sai-ydev/ESP32C3-RF/README.md

# ESP32C3-RF
 
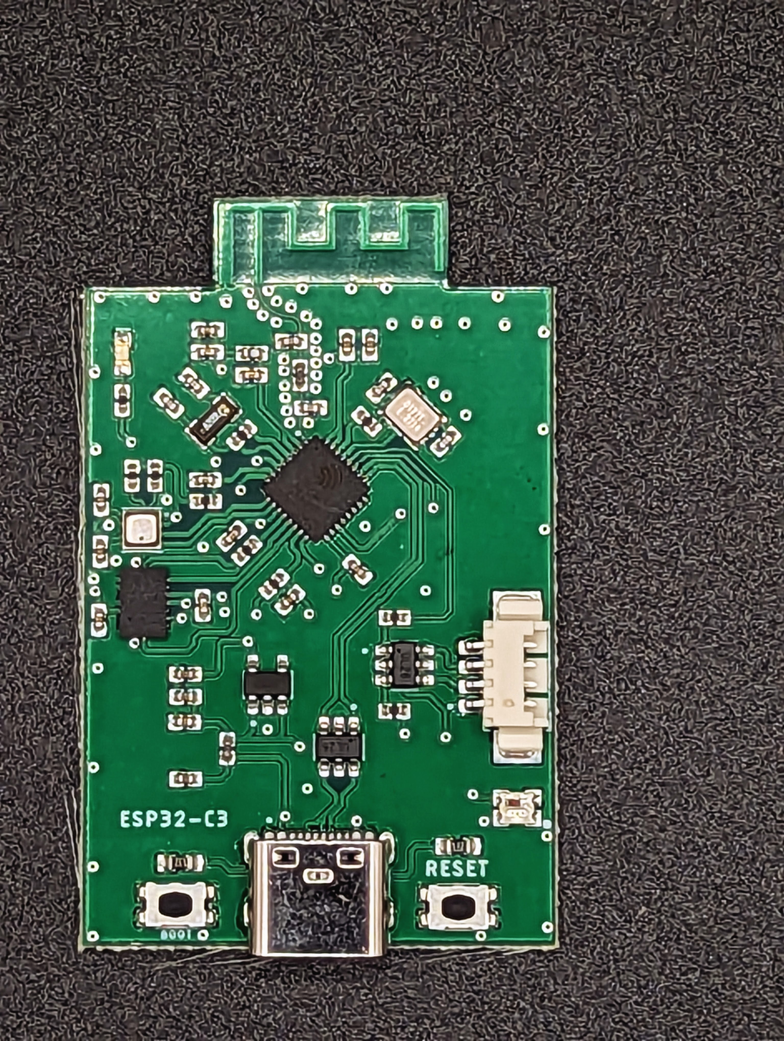
[picture p1: img/esp32_pcb_assembled.jpg]
PCB
