sai-ydev/ESP32C3-RF/hardware/gerbers/esp32_rf_top_bom.xlsx

Comment | Designator | Footprint | LCSC Part #
0.1uF | C5 C6 C8 C9 C10 C11 C12 C13 C16 C17 C18 C19 C20 C22 C23 | 402 | CL05B104KO5NNNC
1.0uF | C3 C4 | 402 | 0402X105K250NT
2.2NH | L4 L2 | 402 | HFM1005-2N2S
2nH | L1 | 402 | BSCH001005052N0SCS
3.3pF | C21 C24 | 402 | AC0402BRNPO9BN3R3
4.7K | R11 R12 | 402 | SCR0402J4K7
5.1k | R1 R2 | 603 | RMC06035.1K1%N
8pF | C1 C2 C14 C15 | 402 | C0402C0G8R0C500NTB
10K | R4 R6 | 402 | SCR0402J0103
10M | R5 | 402 | SCR0402F10M
22 | R3 R7 | 402 | CR0402J22R0Q10Z
330 | R10 | 402 | SCR0603F330R
470 | R8 R9 | 402 | SCR0402F470R
53261-0471 | J2 | MOLEX_53261-0471 | 532610471
AP2112K-3.3TRG1 | U2 | SOT95P285X140-5N | AP2112K-3.3TRG1
BME280 | U5 | PSON65P250X250X100-8N | BME280
BMI055 | IC1 | QFN50P300X450X100-16N | BMI055
ESP32-C3FH4 | U1 | QFN50P500X500X90-33N | ESP32-C3FH4
FC-135_32.7680KA-A0 | Y2 | XTAL_FC-135_32.7680KA-A0 | FC-135 32.7680KA-AC
MOMENTARY-SWITCH-SPST-SMD-4.6X2.8MM | BOOT RESET | TACTILE_SWITCH_SMD_4.6X2.8MM | KMR231GLFS
RED | D1 | LED-0603 | NCD0603R1
TYPE-C-31-M-12 | J1 | HRO_TYPE-C-31-M-12 | TYPE-C-31-M-12
USBLC6-2SC6 | U4 U6 | SOT95P280X145-6N | USBLC6-2SC6
WS2812B-2020 | L3 | WS2812B-2020 | WS2812B-2020
X1E000021017700 | Y1 | CRYSTAL-SMD-3.2X2.5MM | X1E000021017700
