sai-ydev/ESP32C3-RF/hardware/esp32_rf.brd

## EAGLE design hardware/esp32_rf.brd (2023-02-13)

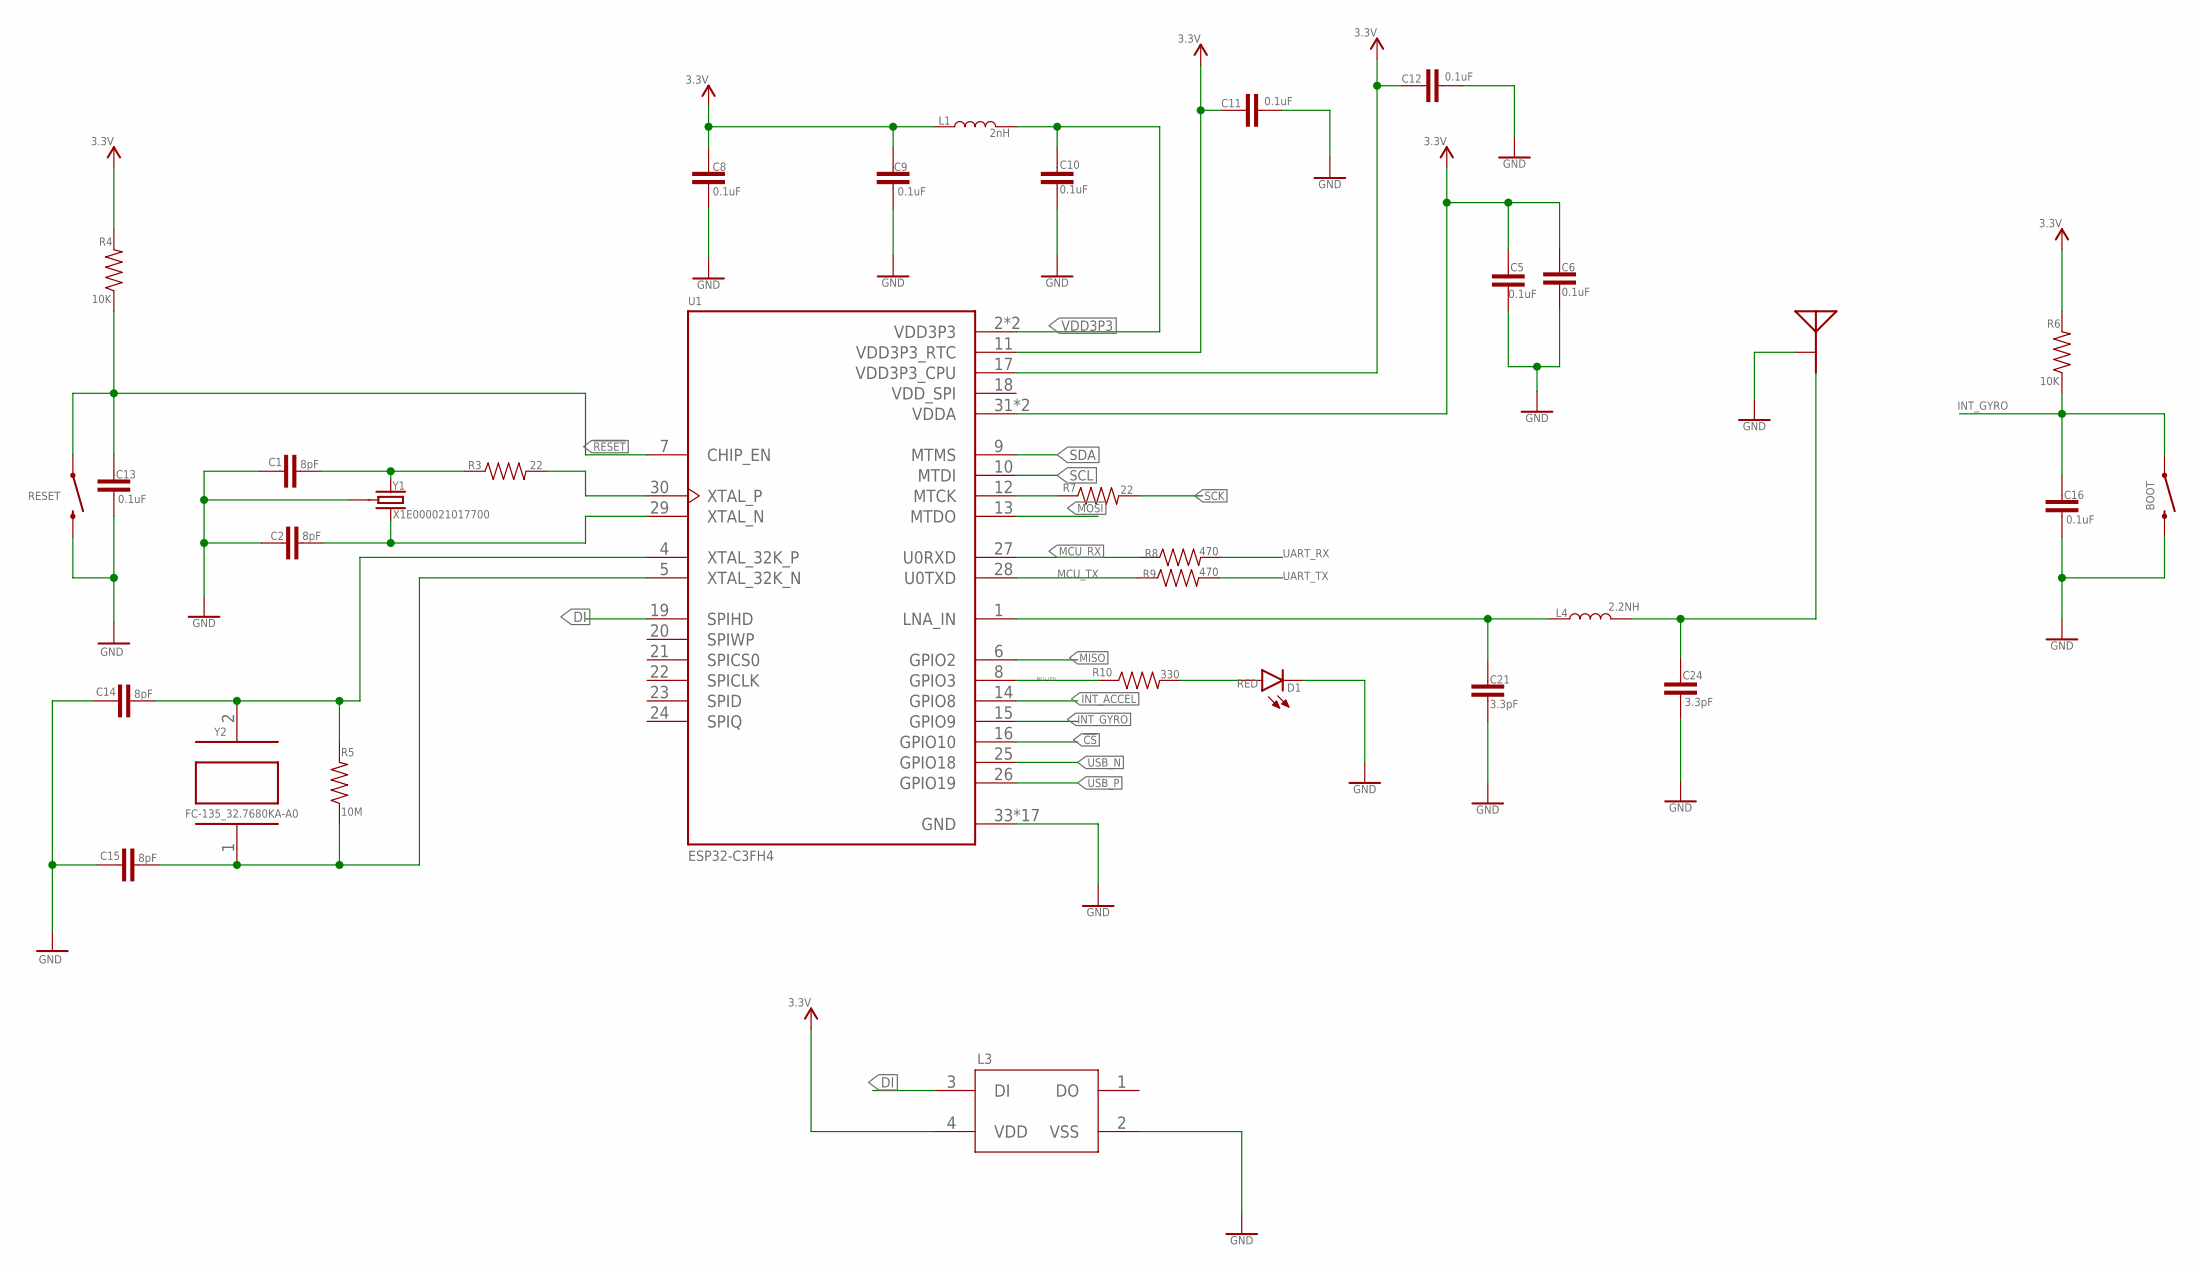
[picture p2: schematic esp32_rf.sch, sheet 1]

Parts:
BOOT: MOMENTARY-SWITCH-SPST-SMD-4.6X2.8MM; TACTILE_SWITCH_SMD_4.6X2.8MM
C1, C2, C14, C15: 8pF; 0402
C5, C6, C8, C9, C10, C11, C12, C13, C16: 0.1uF; 0402
C21, C24: 3.3pF; 0402
D1: RED; LED-0603
L1: 2nH; 0402
L3: WS2812B-2020
L4: 2.2NH; 0402
R3, R7: 22; 0402
R4, R6: 10K; 0402
R5: 10M; 0402
R8, R9: 470; 0402
R10: 330; 0402
RESET: MOMENTARY-SWITCH-SPST-SMD-4.6X2.8MM; TACTILE_SWITCH_SMD_4.6X2.8MM
U1: ESP32-C3FH4; QFN50P500X500X90-33N
U$1: MEANDER-ANT
Y1: X1E000021017700; CRYSTAL-SMD-3.2X2.5MM
Y2: FC-135_32.7680KA-A0; XTAL_FC-135_32.7680KA-A0

Connections:
3.3V: C5.1, C6.1, C8.1, C9.2, C11.2, C12.2, L1.1, L3.4 (VDD), R4.2, R6.2, U1.11 (VDD3P3_RTC), U1.17 (VDD3P3_CPU), U1.31 (VDDA), U1.32 (VDDA); also elsewhere on the board
!CS: U1.16 (GPIO10); also elsewhere on the board
!RESET: C13.1, R4.1, RESET.1, RESET.2 (1), U1.7 (CHIP_EN)
DI: L3.3 (DI), U1.19 (SPIHD)
GND: BOOT.3 (2), BOOT.4 (2), C1.1, C2.1, C5.2, C6.2, C8.2, C9.1, C10.1, C11.1, C12.1, C13.2, C14.1, C15.1, C16.2, C21.2, C24.2, D1.C, L3.2 (VSS), RESET.3 (2), RESET.4 (2), U1.33 (GND), U1.34 (GND), U1.35 (GND), U1.36 (GND), U1.37 (GND), U1.38 (GND), U1.39 (GND), U1.40 (GND), U1.41 (GND), U1.42 (GND), U1.43 (GND), U1.44 (GND), U1.45 (GND), U1.46 (GND), U1.47 (GND), U1.48 (GND), U1.49 (GND), U$1.GND, Y1.2 (3), Y1.4 (3); also elsewhere on the board
INT_ACCEL: U1.14 (GPIO8); also elsewhere on the board
INT_GYRO: BOOT.1, BOOT.2 (1), C16.1, R6.1, U1.15 (GPIO9); also elsewhere on the board
MCU_LED: R10.1, U1.8 (GPIO3)
MCU_RX: R8.1, U1.27 (U0RXD)
MCU_TX: R9.1, U1.28 (U0TXD)
MISO: U1.6 (GPIO2); also elsewhere on the board
MOSI: U1.13 (MTDO); also elsewhere on the board
unnamed: R3.2, U1.30 (XTAL_P)
unnamed: C1.2, R3.1, Y1.1
unnamed: C2.2, U1.29 (XTAL_N), Y1.3 (2)
unnamed: C21.1, L4.1, U1.1 (LNA_IN)
unnamed: C24.1, L4.2, U$1.FEED
unnamed: D1.A, R10.2
unnamed: C14.2, R5.2, U1.4 (XTAL_32K_P), Y2.2
unnamed: C15.2, R5.1, U1.5 (XTAL_32K_N), Y2.1
unnamed: R7.1, U1.12 (MTCK)
SCK: R7.2; also elsewhere on the board
SCL: U1.10 (MTDI); also elsewhere on the board
SDA: U1.9 (MTMS); also elsewhere on the board
UART_RX: R8.2; also elsewhere on the board
UART_TX: R9.2; also elsewhere on the board
USB_N: U1.25 (GPIO18); also elsewhere on the board
USB_P: U1.26 (GPIO19); also elsewhere on the board
VDD3P3: C10.2, L1.2, U1.2 (VDD3P3), U1.3 (VDD3P3)
VDD_SPI: U1.18 (VDD_SPI)

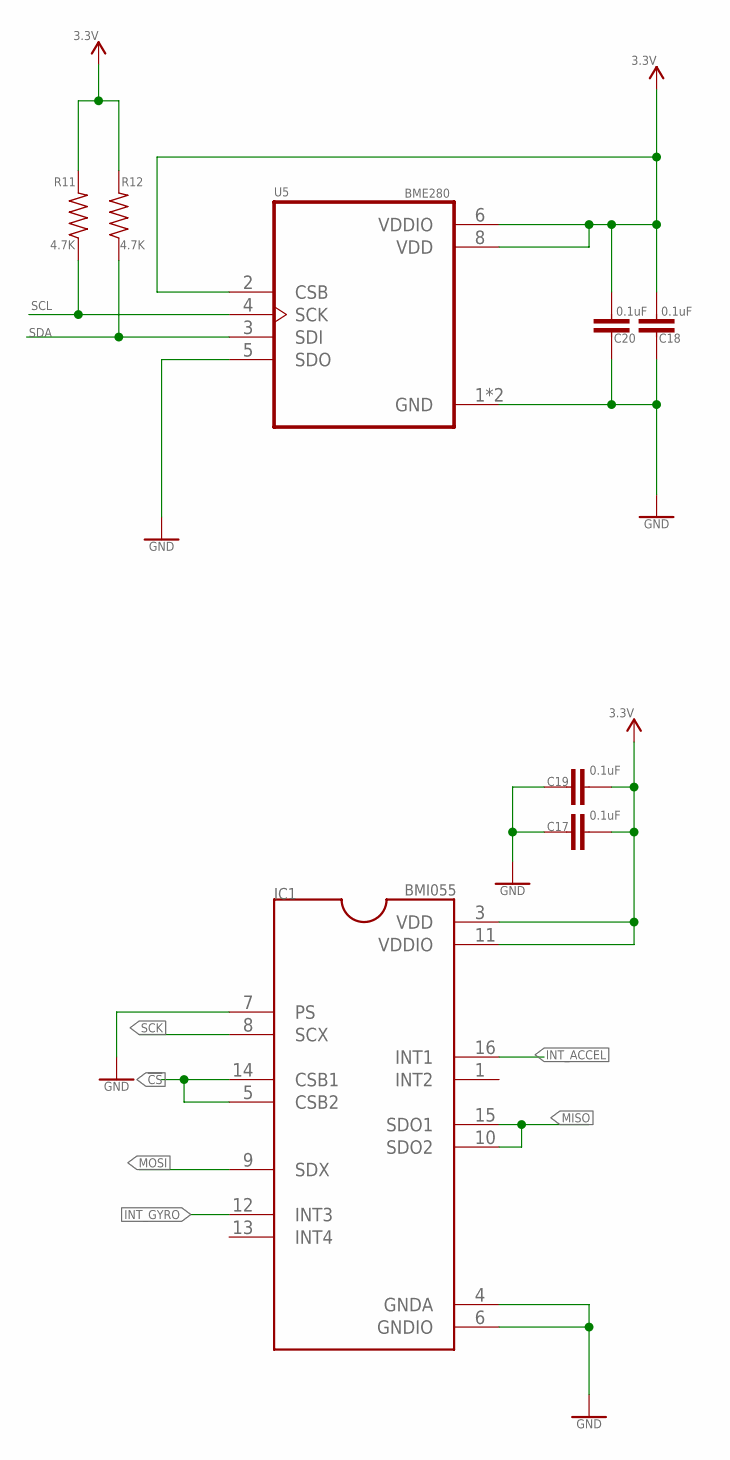
[picture p3: schematic esp32_rf.sch, sheet 2]

Parts:
C17, C18, C19, C20: 0.1uF; 0402
IC1: BMI055; QFN50P300X450X100-16N
R11, R12: 4.7K; 0402
U5: BME280; PSON65P250X250X100-8N

Connections:
3.3V: C17.2, C18.2, C19.2, C20.2, IC1.3 (VDD), IC1.11 (VDDIO), R11.2, R12.2, U5.2 (CSB), U5.6 (VDDIO), U5.8 (VDD); also elsewhere on the board
!CS: IC1.5 (CSB2), IC1.14 (CSB1); also elsewhere on the board
GND: C17.1, C18.1, C19.1, C20.1, IC1.4 (GNDA), IC1.6 (GNDIO), IC1.7 (PS), U5.1 (GND), U5.5 (SDO), U5.7 (GND); also elsewhere on the board
INT_ACCEL: IC1.16 (INT1); also elsewhere on the board
INT_GYRO: IC1.12 (INT3); also elsewhere on the board
MISO: IC1.10 (SDO2), IC1.15 (SDO1); also elsewhere on the board
MOSI: IC1.9 (SDX); also elsewhere on the board
SCK: IC1.8 (SCX); also elsewhere on the board
SCL: R11.1, U5.4 (SCK); also elsewhere on the board
SDA: R12.1, U5.3 (SDI); also elsewhere on the board

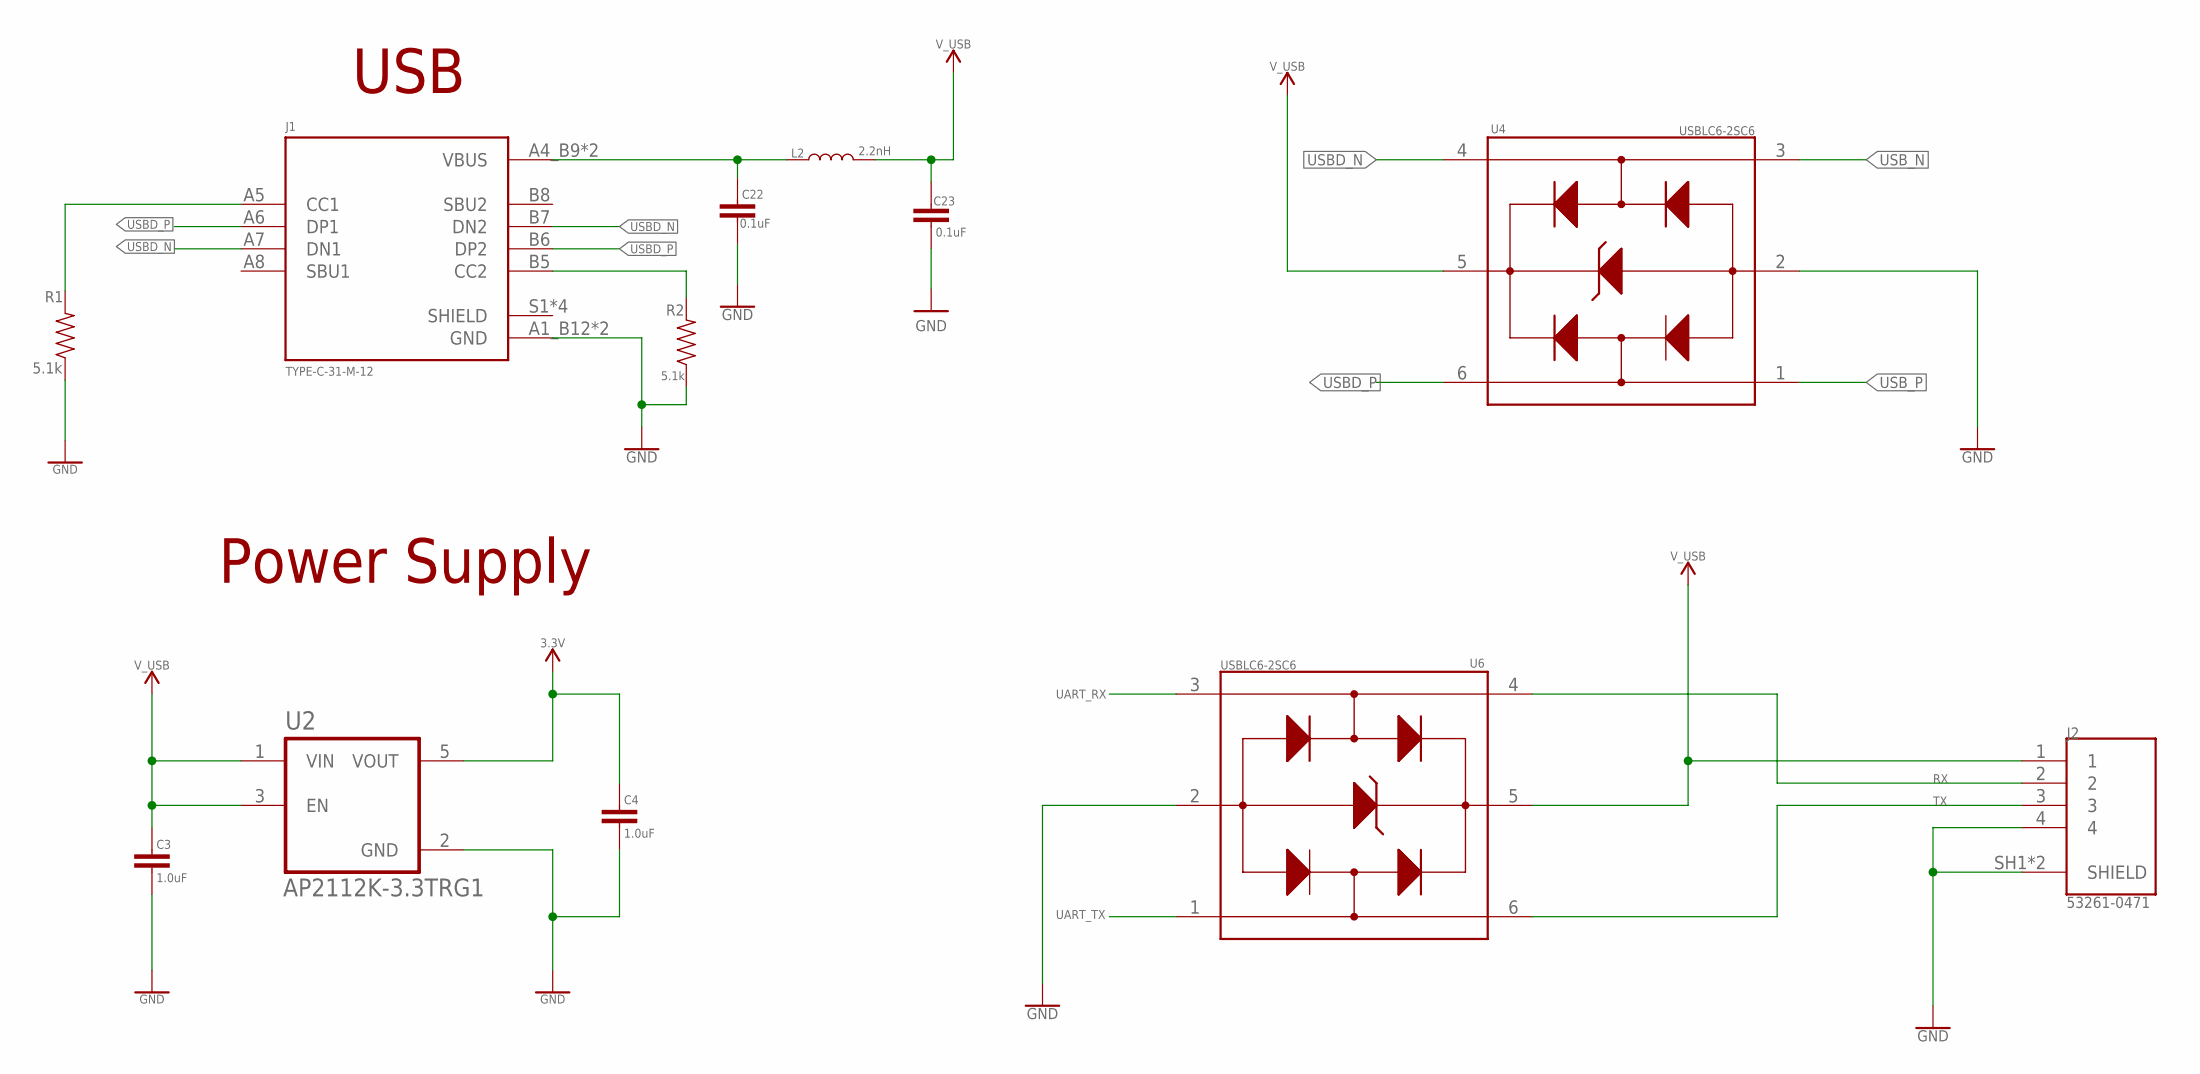
[picture p4: schematic esp32_rf.sch, sheet 3]

Parts:
C3, C4: 1.0uF; 0402
C22, C23: 0.1uF; 0402
J1: TYPE-C-31-M-12; HRO_TYPE-C-31-M-12
J2: 53261-0471; MOLEX_53261-0471
L2: 2.2nH; 0402
R1, R2: 5.1k; 0603
U2: AP2112K-3.3TRG1; SOT95P285X140-5N
U4, U6: USBLC6-2SC6; SOT95P280X145-6N

Connections:
3.3V: C4.1, U2.5 (VOUT); also elsewhere on the board
GND: C3.2, C4.2, C22.2, C23.2, J1.A1_B12 (GND), J1.B1_A12 (GND), J2.4, J2.SH1 (SHIELD), J2.SH2 (SHIELD), R1.1, R2.1, U2.2 (GND), U4.2 (GND), U6.2 (GND); also elsewhere on the board
unnamed: J1.A5 (CC1), R1.2
unnamed: J1.B5 (CC2), R2.2
unnamed: C22.1, J1.A4_B9 (VBUS), J1.B4_A9 (VBUS), L2.1
RX: J2.2, U6.4 (I/O2_OUT)
TX: J2.3, U6.6 (I/O1_OUT)
UART_RX: U6.3 (I/O2_IN); also elsewhere on the board
UART_TX: U6.1 (I/O1_IN); also elsewhere on the board
USBD_N: J1.A7 (DN1), J1.B7 (DN2), U4.4 (I/O2_OUT)
USBD_P: J1.A6 (DP1), J1.B6 (DP2), U4.6 (I/O1_OUT)
USB_N: U4.3 (I/O2_IN); also elsewhere on the board
USB_P: U4.1 (I/O1_IN); also elsewhere on the board
V_USB: C3.1, C23.1, J2.1, L2.2, U2.1 (VIN), U2.3 (EN), U4.5 (VBUS), U6.5 (VBUS)

Notes on the sheet:
Power Supply
USB

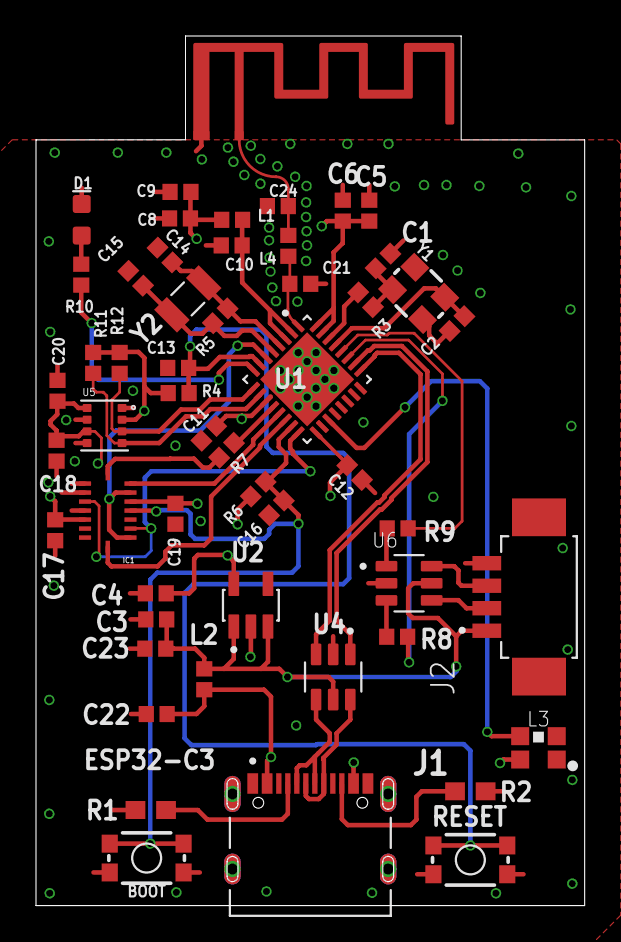
[picture p5: board esp32_rf.brd from above]

Board: 4 copper layers, 30.5 x 48.3 mm, 53 parts (0 on the bottom side), 37 nets.
