sai-ydev/ESP32C3-RF/(commit log)

2023-01-17 Updated libraries and schematic
    [esp32_rf.brd, esp32_rf.sch]
2023-01-18 Updated schematic
    [esp32_rf.brd, esp32_rf.sch]
2023-01-20 Design Files
    [esp32_rf.brd, esp32_rf.sch]
2023-01-30 Design files check-in
    [esp32_rf.brd, esp32_rf.sch, esp32_rf_BoM.xlsx, esp32_rf_centroid.xlsx]
2023-01-31 BoM files
    [esp32_rf_top_bom.csv, esp32_rf_top_bom.xlsx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]
2023-02-13 Board check-in
    [esp32_rf.brd, esp32_rf.sch]
